hansj66/automaton-xl320/firmware/esp/balance-bot/README.md

## Suggested initial PID settings

P: 274
I: 1657
D: 3.3
Setpoint: 90.12
