hansj66/automaton-xl320/hardware/fusion/balance-bot/balancebot.jpg

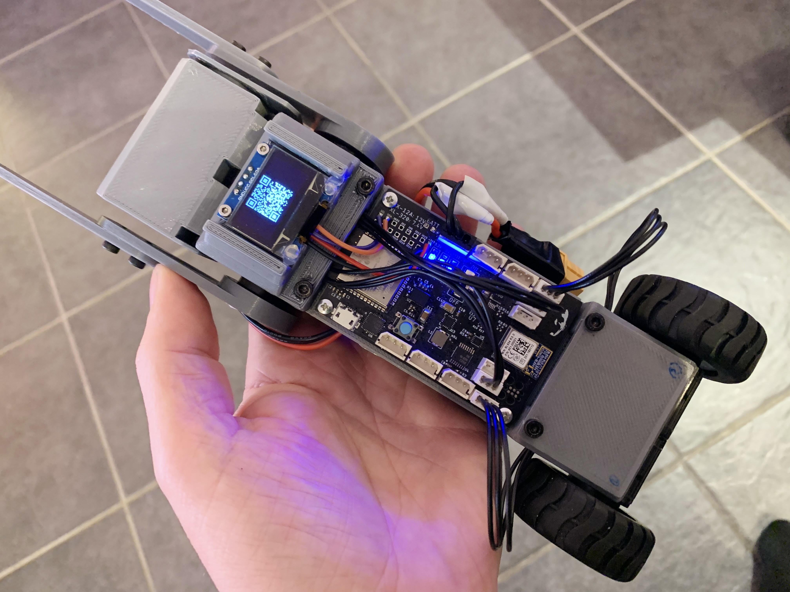
hardware/fusion/balance-bot/balancebot.jpg
