hansj66/automaton-xl320/hardware/fusion/hexapod/crab.png

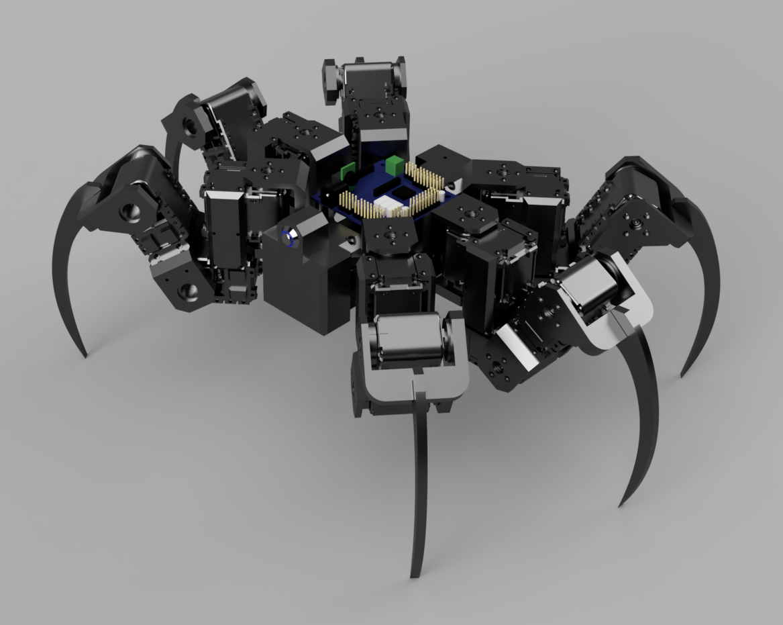
hardware/fusion/hexapod/crab.png
