hansj66/automaton-xl320/hardware/fusion/balance-bot/step/battery_cover.step

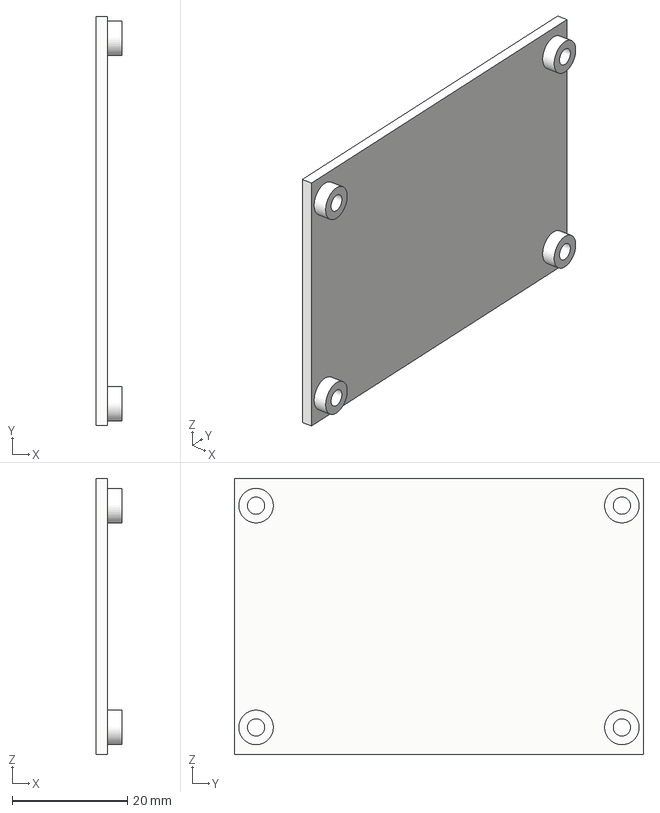
[picture p4: CAD file, 2021-12-13]
hardware/fusion/balance-bot/step/battery_cover.step
4.50 x 71.0 x 48.0 mm
