hansj66/automaton-xl320/hardware/fusion/hexapod/step/coxa.step

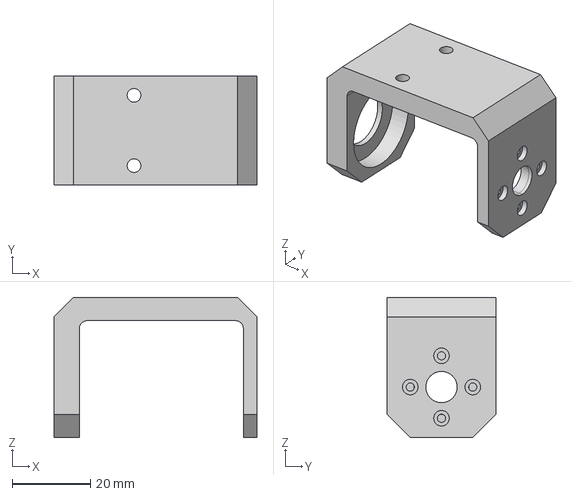
[picture p5: CAD file, 2021-09-20]
hardware/fusion/hexapod/step/coxa.step
52.0 x 27.8 x 36.0 mm
