hansj66/automaton-xl320/hardware/fusion/balance-bot/step/wide_wheel_hub_v2.step

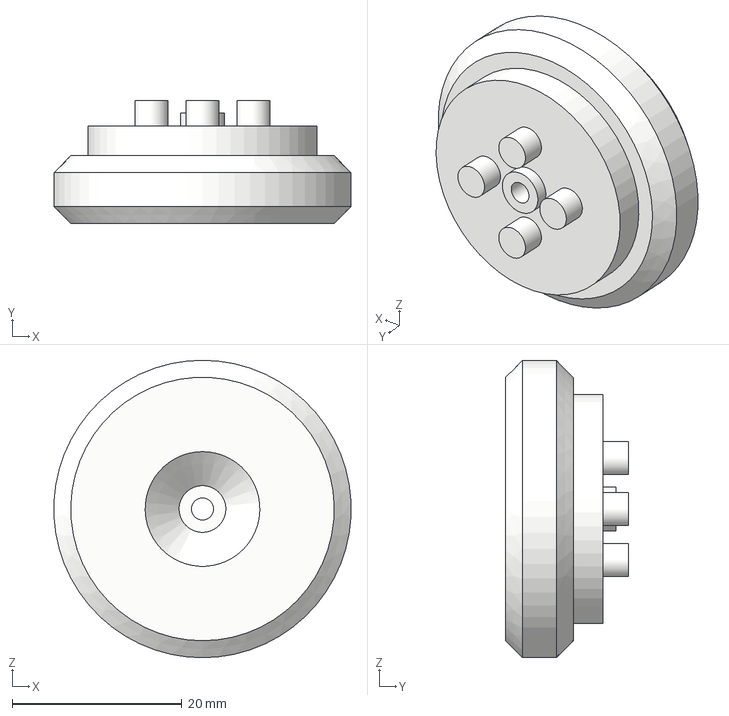
[picture p6: CAD file, 2021-12-13]
hardware/fusion/balance-bot/step/wide_wheel_hub_v2.step
34.9 x 14.5 x 35.0 mm
