hansj66/automaton-xl320/hardware/fusion/hexapod/step/end_effector.step

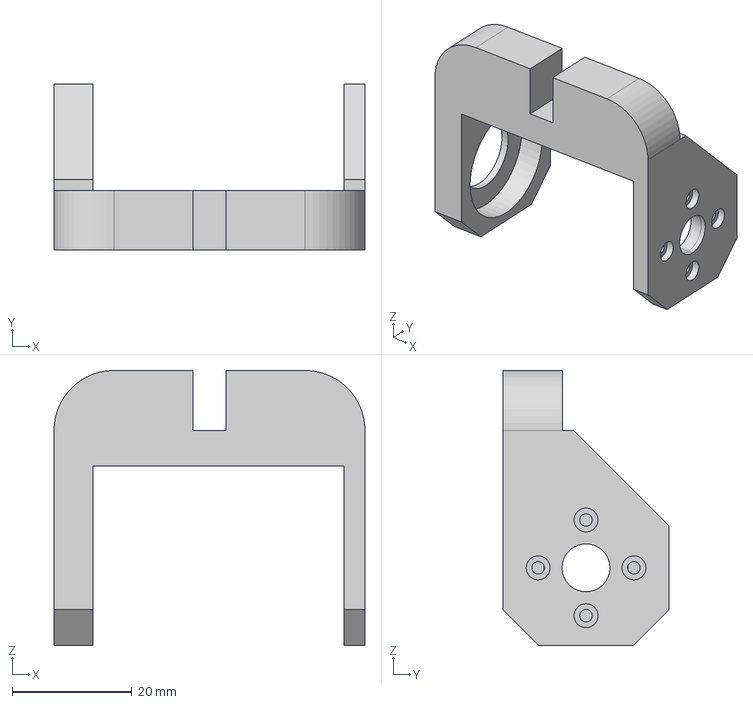
[picture p7: CAD file, 2021-09-20]
hardware/fusion/hexapod/step/end_effector.step
52.0 x 27.8 x 46.0 mm
