hansj66/automaton-xl320/hardware/fusion/balance-bot/step/servo_cover_2.step

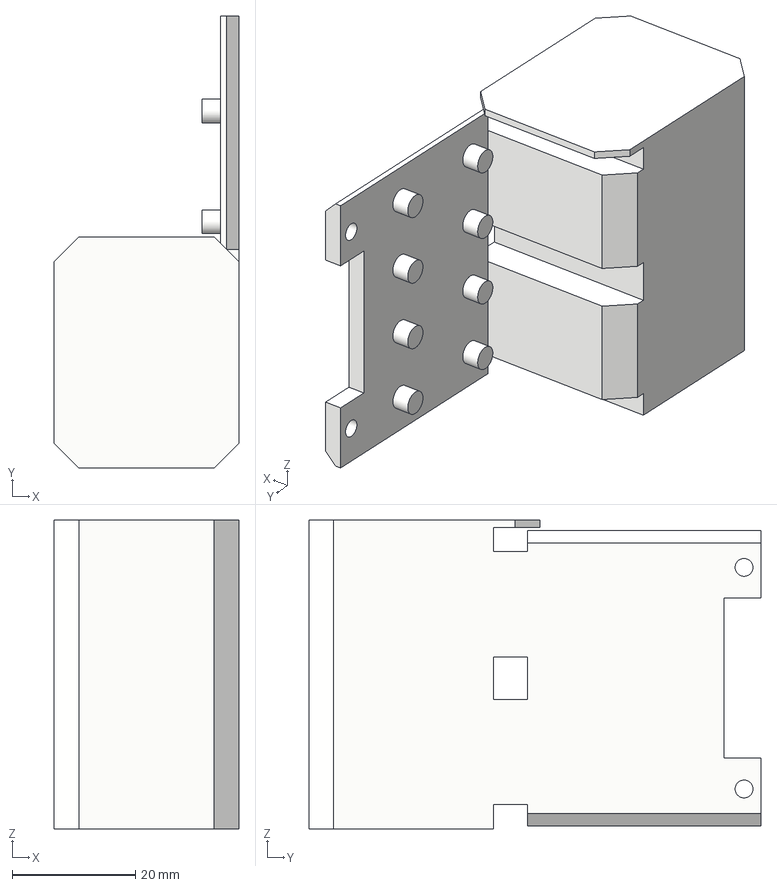
[picture p8: CAD file, 2021-12-13]
hardware/fusion/balance-bot/step/servo_cover_2.step
30.0 x 73.4 x 50.2 mm
