hansj66/automaton-xl320/hardware/fusion/hexapod/step/battery_clamp1.step

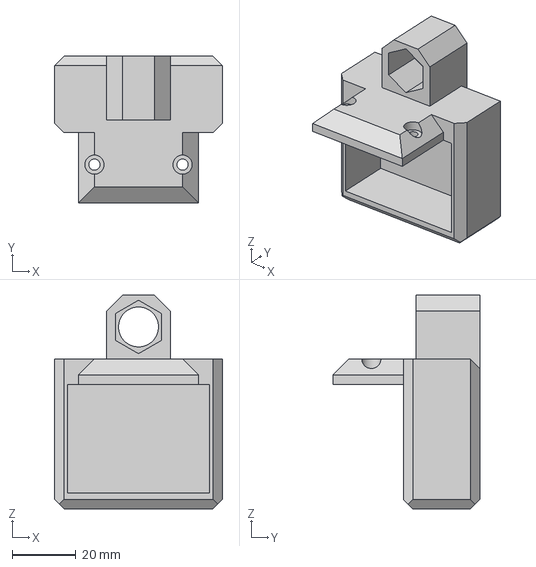
[picture p9: CAD file, 2021-09-20]
hardware/fusion/hexapod/step/battery_clamp1.step
52.6 x 46.0 x 67.0 mm
