hansj66/automaton-xl320/hardware/fusion/balance-bot/step/ballast_cover.step

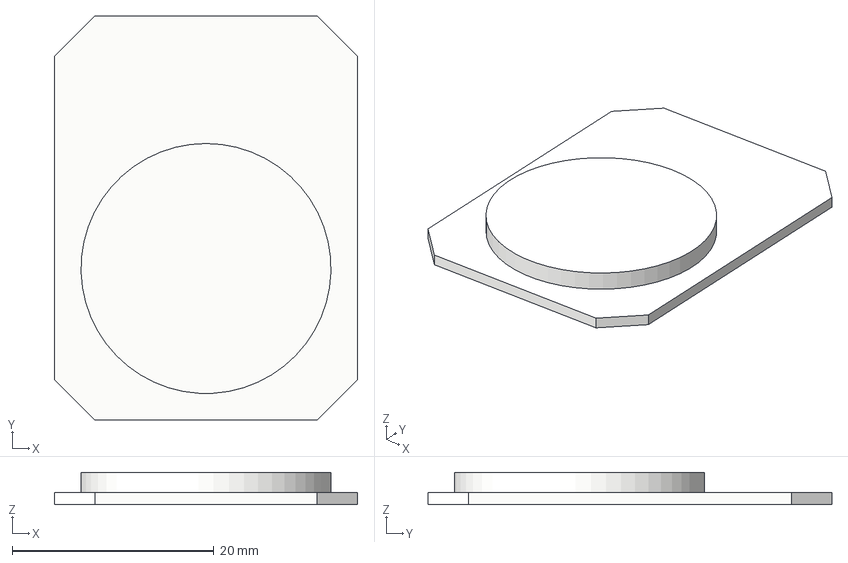
[picture p10: CAD file, 2021-12-13]
hardware/fusion/balance-bot/step/ballast_cover.step
30.0 x 40.0 x 3.20 mm
