hansj66/automaton-xl320/hardware/fusion/hexapod/step/tibia.step

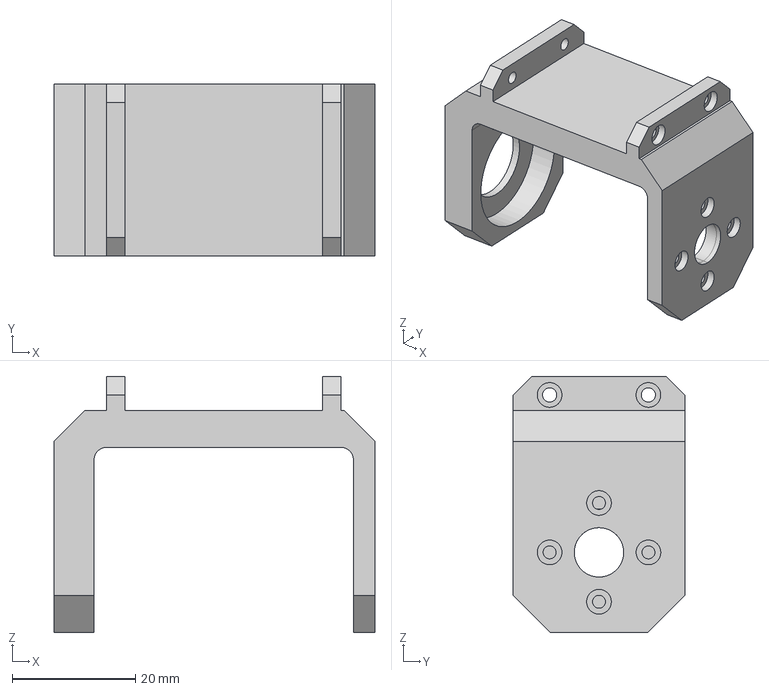
[picture p11: CAD file, 2021-09-20]
hardware/fusion/hexapod/step/tibia.step
52.0 x 27.8 x 41.5 mm
