hansj66/automaton-xl320/hardware/fusion/balance-bot/step/servo_cover_wheels.step

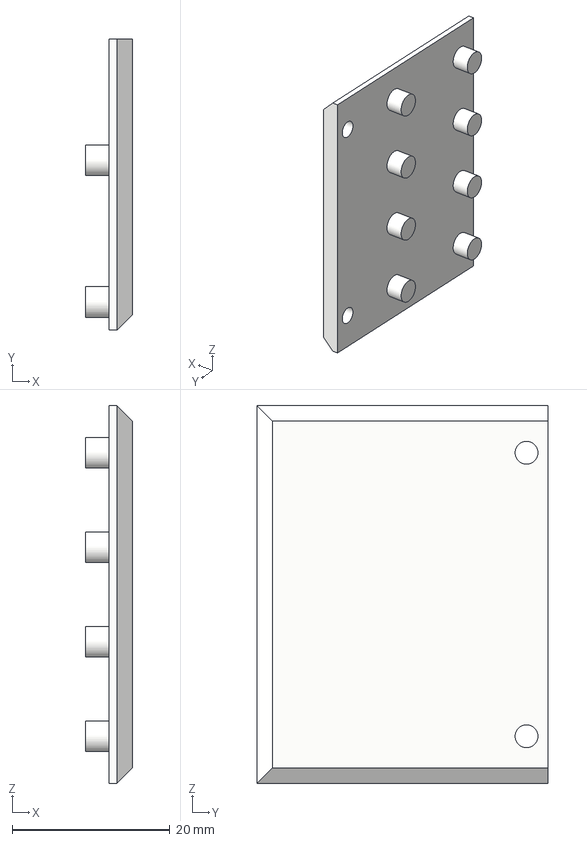
[picture p12: CAD file, 2021-12-13]
hardware/fusion/balance-bot/step/servo_cover_wheels.step
6.00 x 37.0 x 48.0 mm
