hansj66/automaton-xl320/hardware/fusion/hexapod/step/femur.step

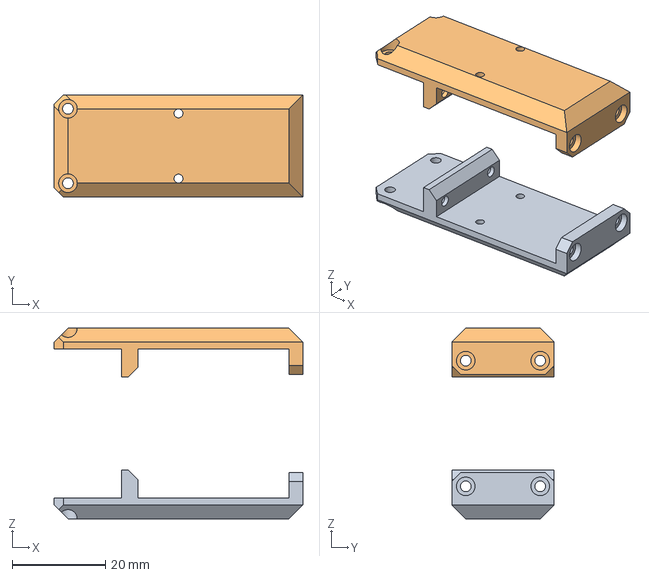
[picture p13: CAD file, 2021-09-20]
hardware/fusion/hexapod/step/femur.step
53.5 x 22.0 x 41.0 mm
