hansj66/automaton-xl320/hardware/fusion/balance-bot/step/arm.step

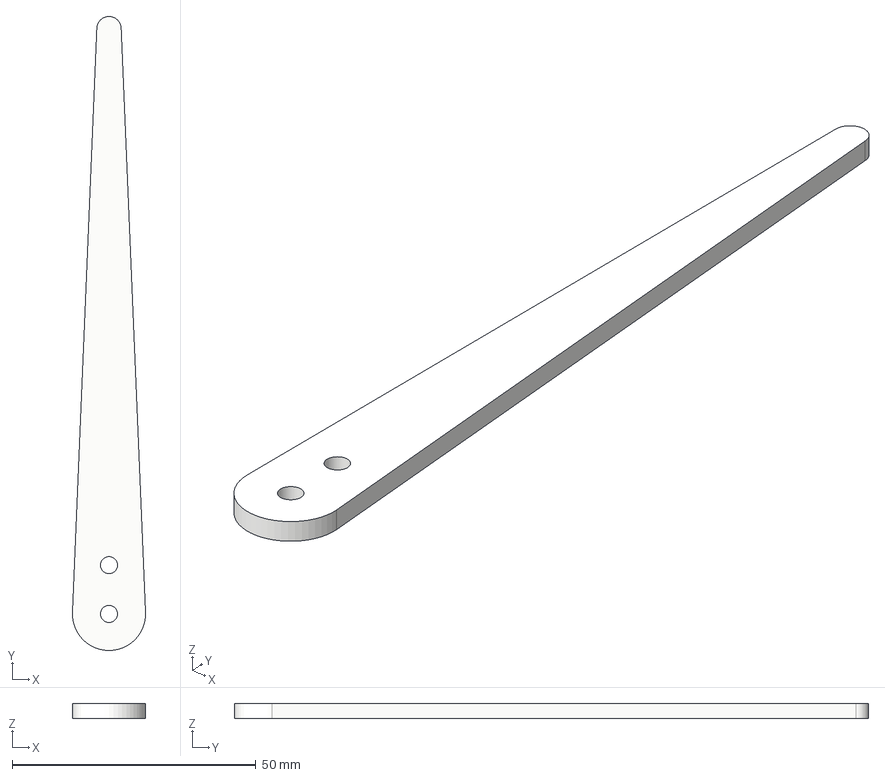
[picture p14: CAD file, 2021-12-13]
hardware/fusion/balance-bot/step/arm.step
15.0 x 130.0 x 3.00 mm
