hansj66/automaton-xl320/hardware/fusion/hexapod/step/Claw.step

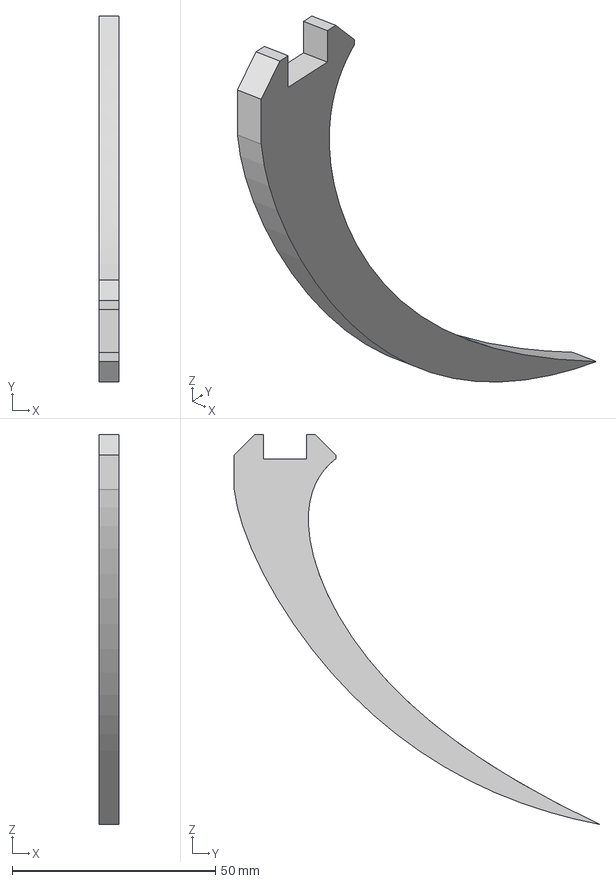
[picture p15: CAD file, 2021-09-20]
hardware/fusion/hexapod/step/Claw.step
5.00 x 90.0 x 96.0 mm
