hansj66/automaton-xl320/hardware/fusion/balance-bot/step/servo_cover_screen.step

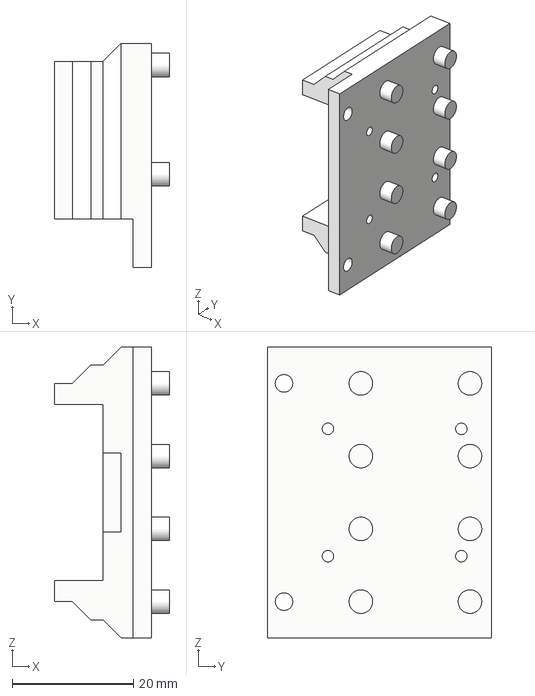
[picture p16: CAD file, 2021-12-13]
hardware/fusion/balance-bot/step/servo_cover_screen.step
19.0 x 37.0 x 48.0 mm
