hansj66/automaton-xl320/hardware/fusion/hexapod/step/pcb_standoff.step

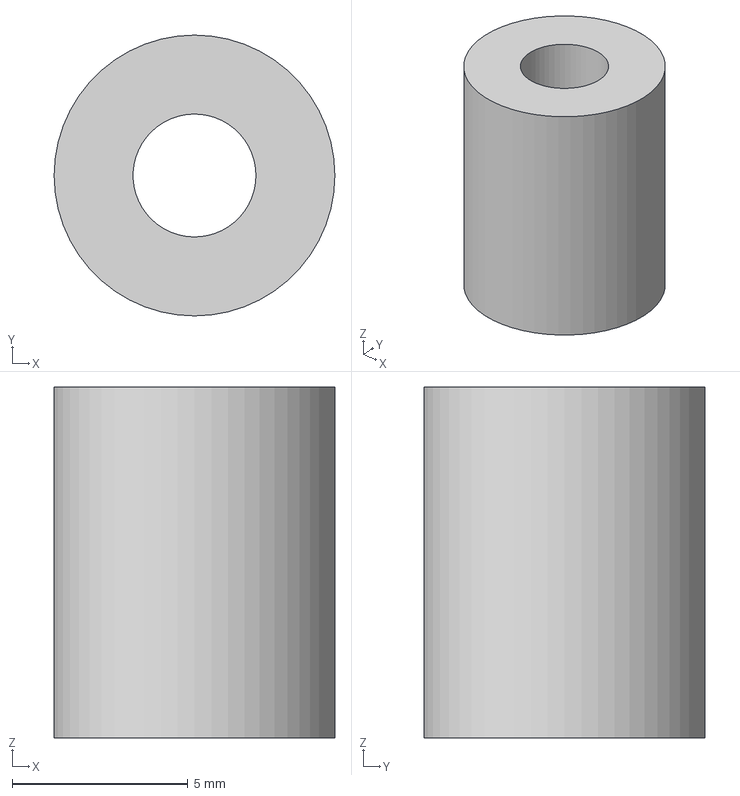
[picture p17: CAD file, 2021-09-20]
hardware/fusion/hexapod/step/pcb_standoff.step
8.00 x 8.00 x 10.00 mm
