hansj66/automaton-xl320/hardware/fusion/balance-bot/step/XL-320 v1.step

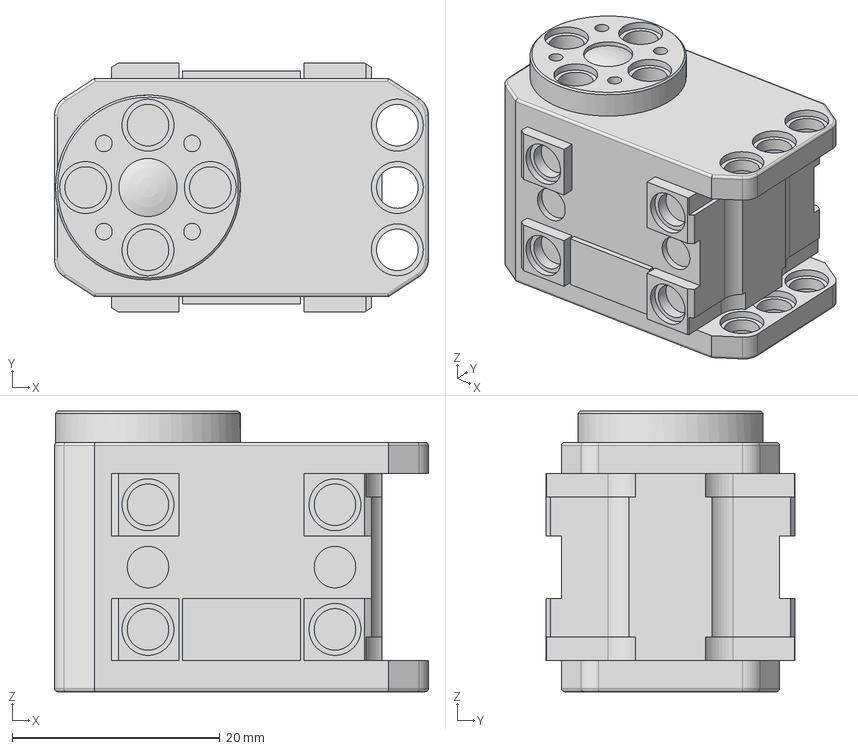
[picture p18: CAD file, 2021-12-13]
hardware/fusion/balance-bot/step/XL-320 v1.step
36.0 x 24.0 x 27.0 mm
