hansj66/automaton-xl320/hardware/fusion/hexapod/step/frame.step

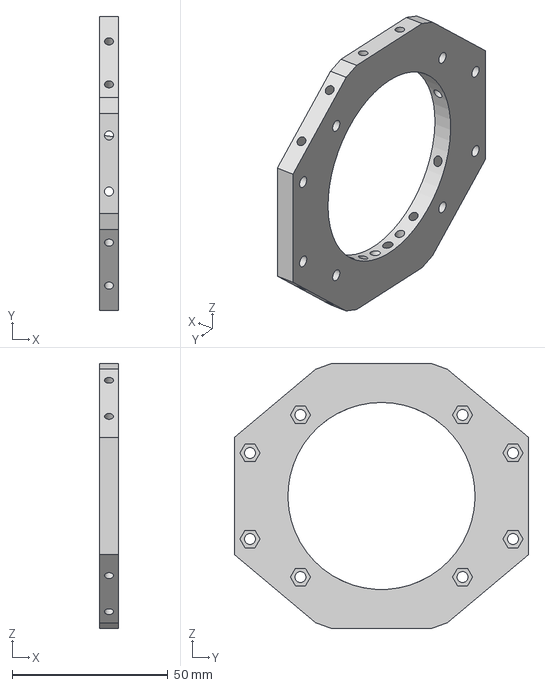
[picture p19: CAD file, 2021-09-20]
hardware/fusion/hexapod/step/frame.step
6.00 x 94.4 x 85.0 mm
