hansj66/automaton-xl320/hardware/fusion/balance-bot/step/shoulder_joint.step

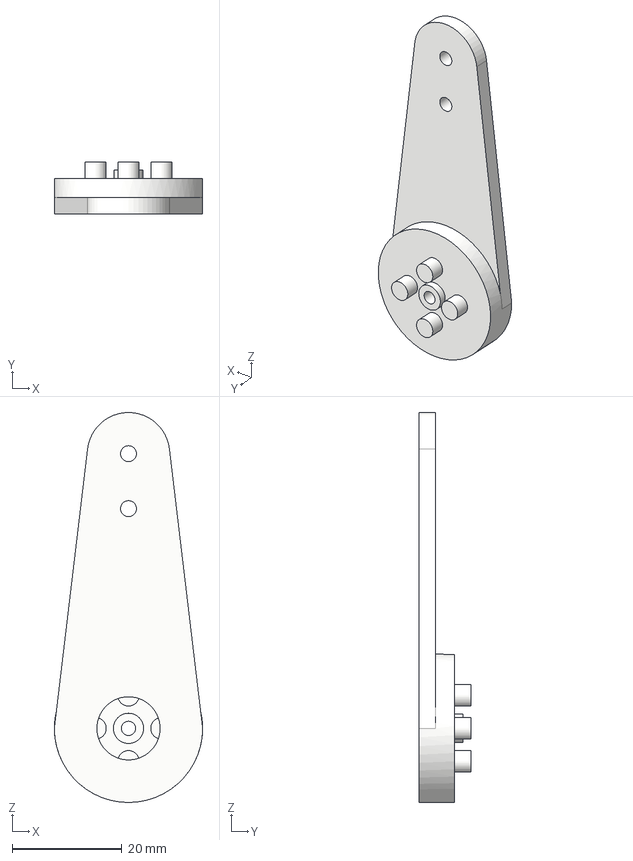
[picture p20: CAD file, 2021-12-13]
hardware/fusion/balance-bot/step/shoulder_joint.step
27.0 x 9.50 x 71.0 mm
