hansj66/automaton-xl320/hardware/fusion/hexapod/step/battery_clamp2.step

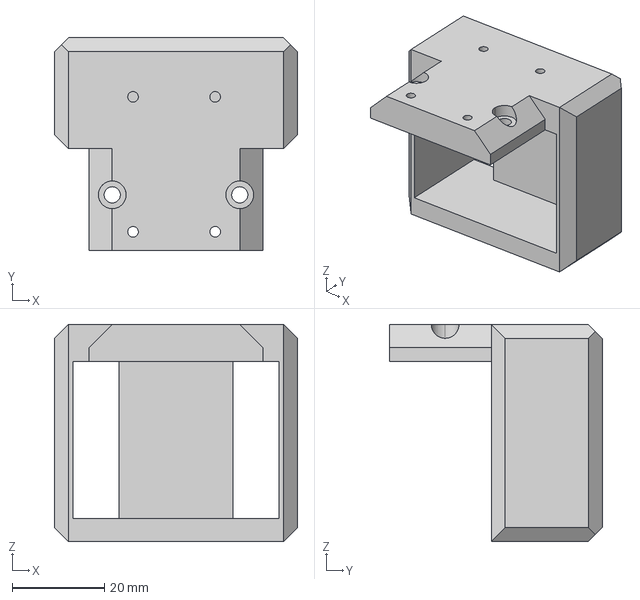
[picture p21: CAD file, 2021-09-20]
hardware/fusion/hexapod/step/battery_clamp2.step
52.6 x 46.0 x 47.0 mm
