hansj66/automaton-xl320/(list of files, cad)

Other CAD files:
hardware/fusion/balance-bot/step/bb_battery_cover.step
hardware/fusion/balance-bot/stl/arm.stl
hardware/fusion/balance-bot/stl/ballast_cover.stl
hardware/fusion/balance-bot/stl/battery_cover.stl
hardware/fusion/balance-bot/stl/servo_cover_screen.stl
hardware/fusion/balance-bot/stl/servo_cover_wheels.stl
hardware/fusion/balance-bot/stl/shoulder_joint.stl
hardware/fusion/balance-bot/stl/wide_wheel_hub_v2.stl
hardware/fusion/hexapod/stl/battery_clamp1.stl
hardware/fusion/hexapod/stl/battery_clamp2.stl
hardware/fusion/hexapod/stl/claw.stl
hardware/fusion/hexapod/stl/coxa.stl
hardware/fusion/hexapod/stl/end_effector.stl
hardware/fusion/hexapod/stl/femur.stl
hardware/fusion/hexapod/stl/frame.stl
hardware/fusion/hexapod/stl/pcb_standoff.stl
hardware/fusion/hexapod/stl/tibia.stl
