hansj66/automaton-xl320/hardware/eagle/AutomatonXL320/AutomatonXL320.brd

## EAGLE design hardware/eagle/AutomatonXL320/AutomatonXL320.brd (2024-04-30)

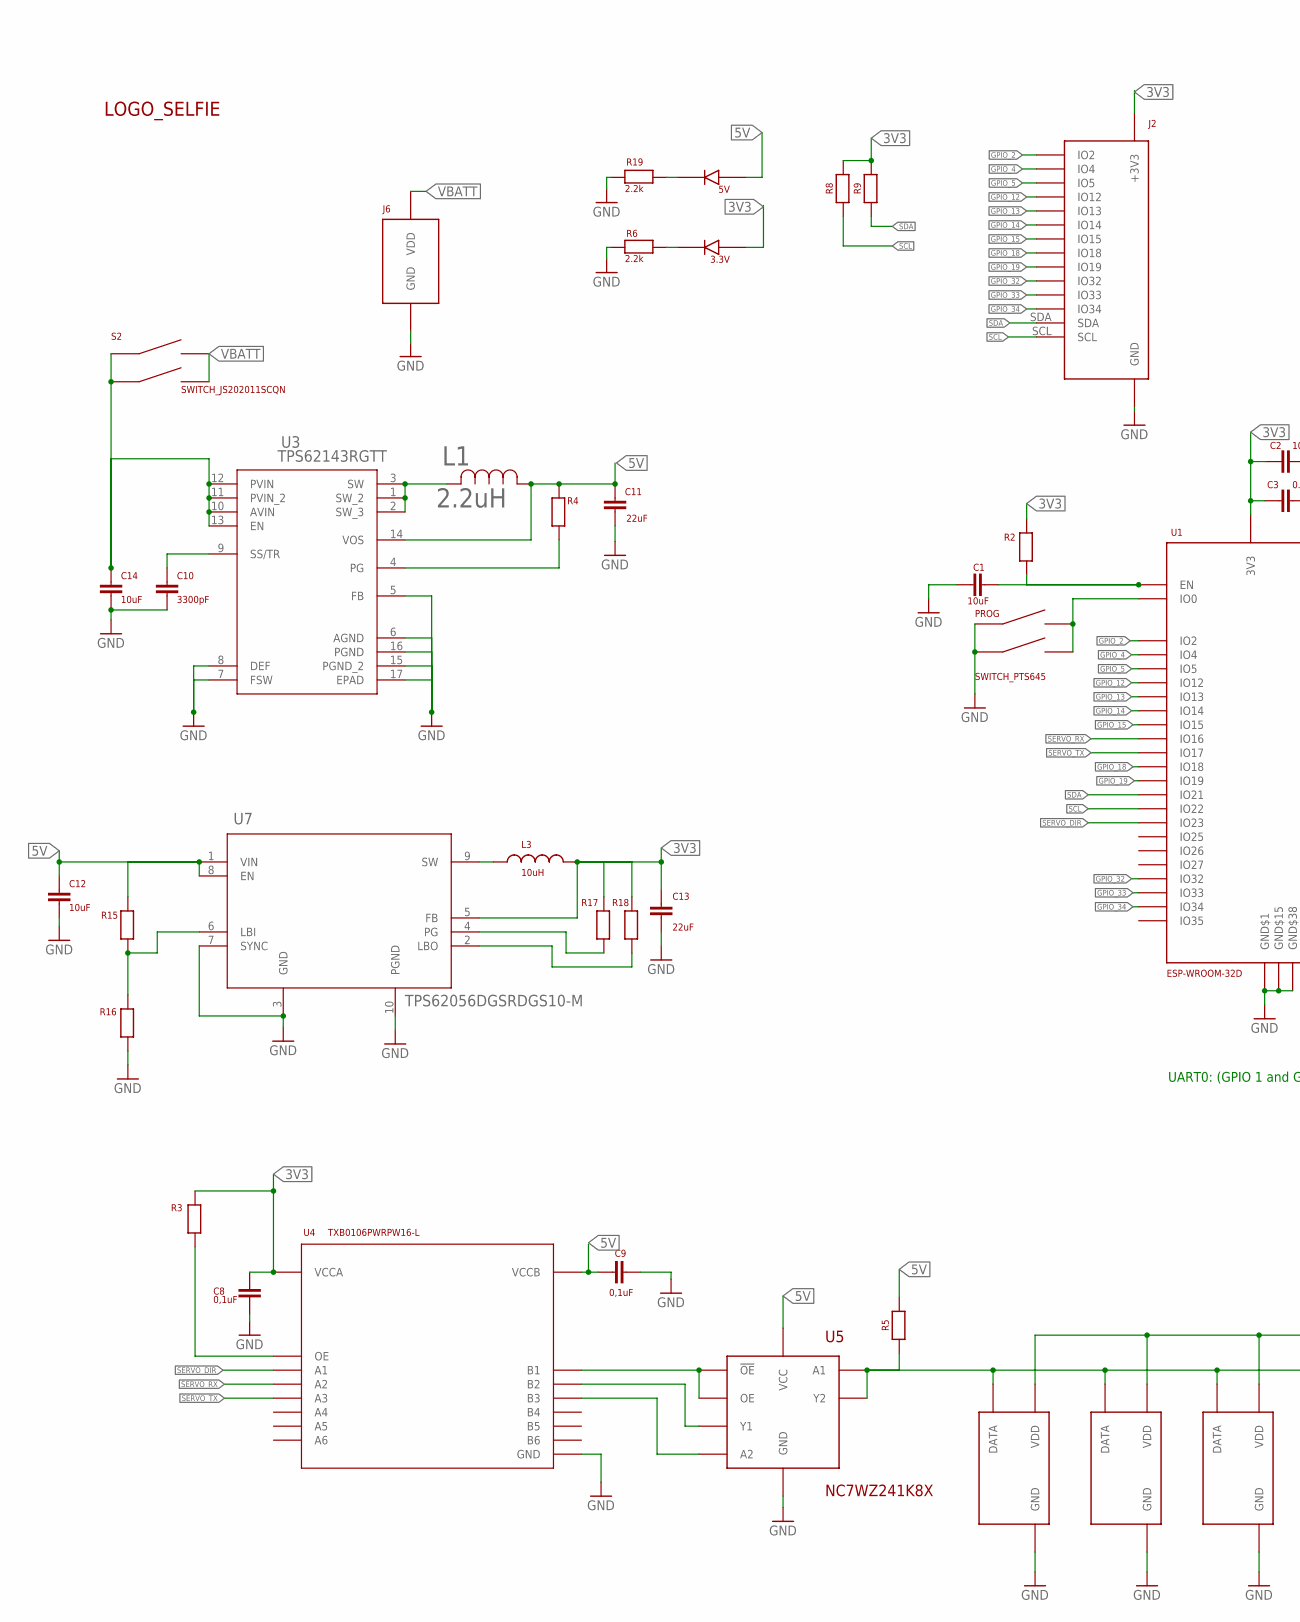
[picture p22: schematic AutomatonXL320.sch, part in row 1, column 1]

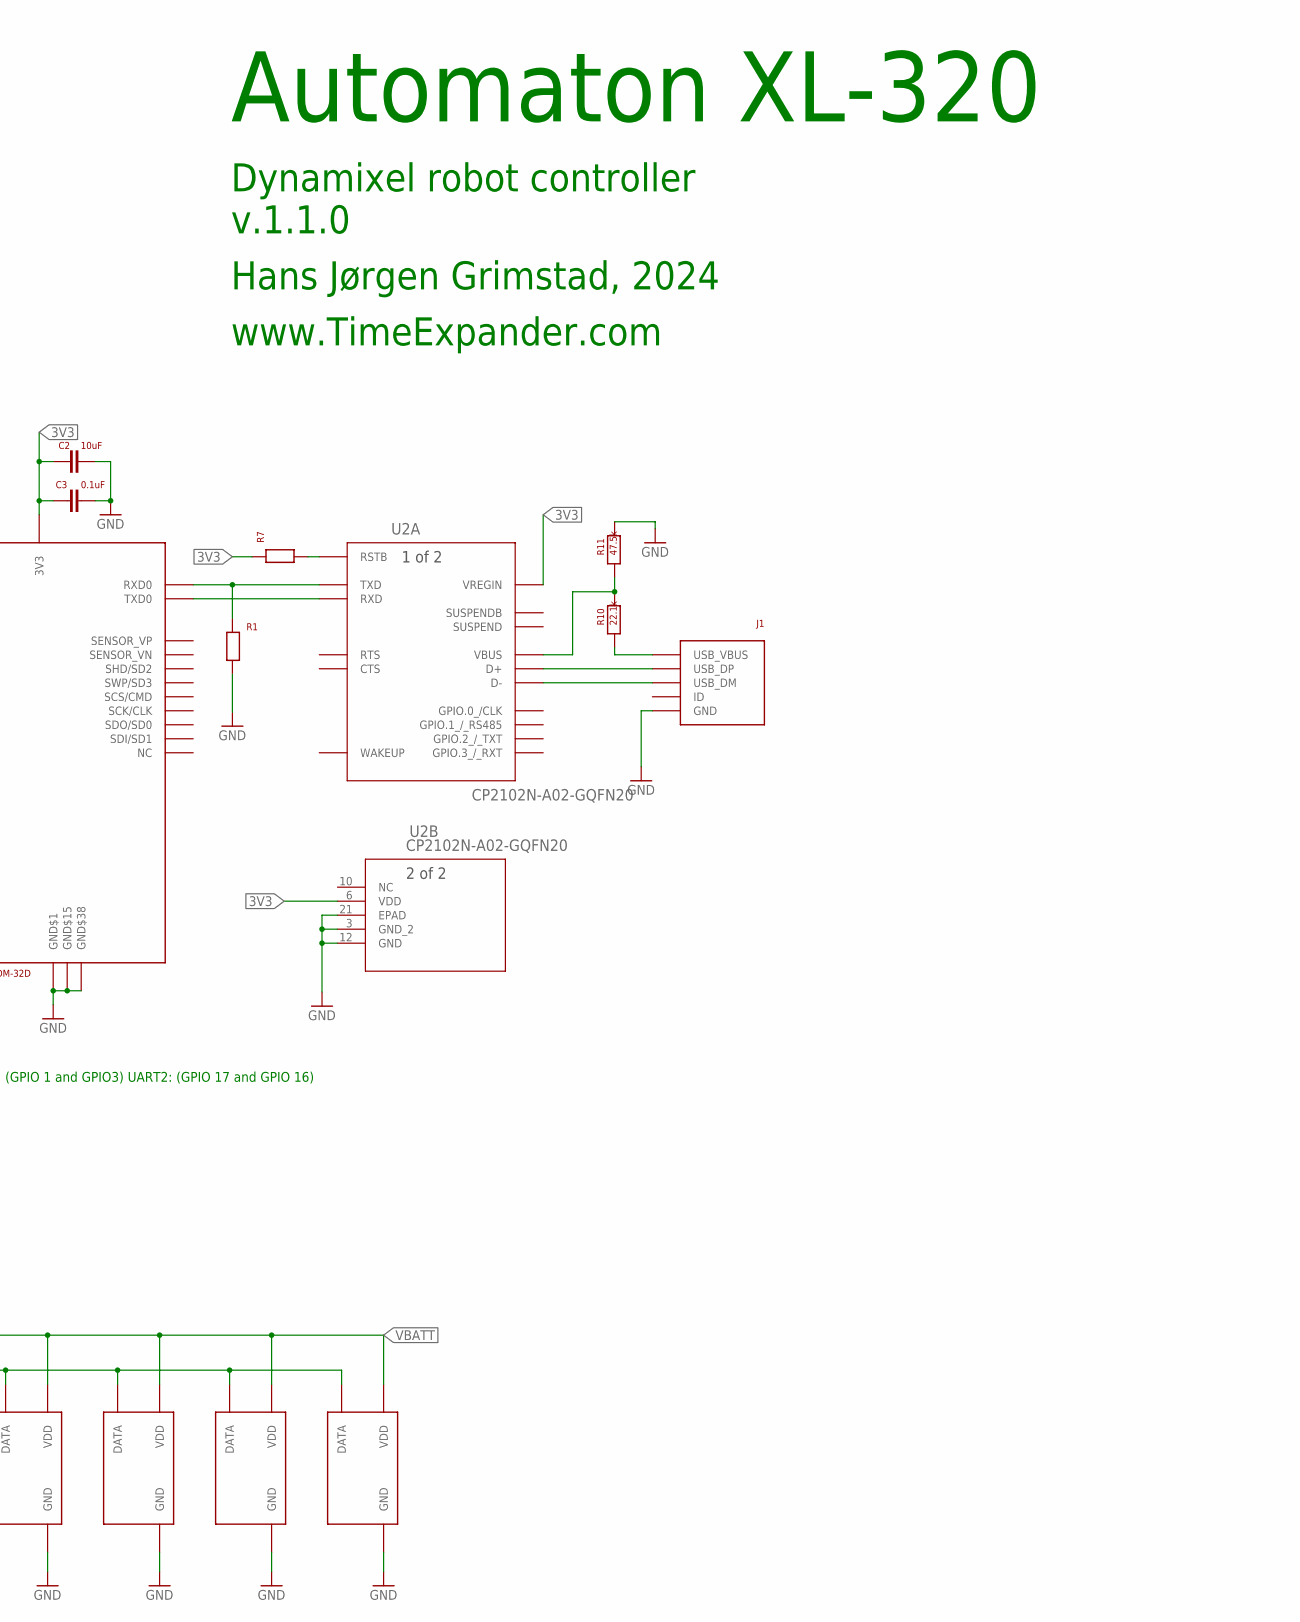
[picture p23: schematic AutomatonXL320.sch, part in row 1, column 2]

Parts:
3.3V, 5V: LED_APTR3216PBC/A
C1, C2: 10uF; CAP_0402
C3: 0.1uF; CAP_0402
C8, C9: 0,1uF; CAP_0402
C10: 3300pF; CAP_0402
C11, C13: 22uF; CAP_1206
C12, C14: 10uF; CAP_1206
J1: USB_RCPT_10118192-0001LF
J2: ESP_ROBOT_BOARD_GPIO_16
J6: BATTERY; BATTERY_SOLDER_TERMINAL
L1: 2.2uH; IND_IHLP-1616AB-M
L3: 10uH; IND_4028
PROG: SWITCH_PTS645; SWITCH_PTS645_EE_NBIOT_01
R1, R2, R3, R4, R5, R7, R8, R9, R15, R16, R17, R18: RESISTOR0402; RES_0402
R6, R19: 2.2k; RES_0402
R10: 22.1k; RES_0402
R11: 47.5k; RES_0402
S2: SWITCH_JS202011SCQN
U1: ESP-WROOM-32D; ESP_WROOM_32D
U2: CP2102N-A02-GQFN20; QFN20_CP2102N_SIL
U3: TPS62143RGTT; RGT16_1P7X1P7
U4: TXB0106PWRPW16-L; PW16-L
U5: NC7WZ241K8X
U7: TPS62056DGSRDGS10-M; DGS10-M
U$1, U$4, U$5, U$6, U$8, U$9: DYNAMIXEL_MOLEX_MINISPOX_3P_HEADERXL-320; DYNAMIXEL_MICROLATCH_3P_HEADER
U$2: LOGO_SELFIESELFIE_2; TIMEEXPANDER_LOGO_1

Connections:
3V3: 3.3V.A, C2.P$1 (1), C3.P$1 (1), C8.P$2 (2), C13.P$1 (1), J2.+3V3, L3.2, R2.P$2, R3.P$2, R7.P$1, R8.P$2, R9.P$2, R17.P$2, R18.P$2, U1.2 (3V3), U2.6 (VDD), U2.7 (VREGIN), U4.2 (VCCA), U7.5 (FB)
5V: 5V.A, C9.P$1 (1), C11.P$1 (1), C12.P$1 (1), L1.1, R4.P$2, R5.P$2, R15.P$2, U3.14 (VOS), U4.15 (VCCB), U5.VCC, U7.1 (VIN), U7.8 (EN)
GND: C1.P$1 (1), C2.P$2 (2), C3.P$2 (2), C8.P$1 (1), C9.P$2 (2), C10.P$2 (2), C11.P$2 (2), C12.P$2 (2), C13.P$2 (2), C14.P$2 (2), J1.GND, J2.GND, J6.- (GND), PROG.A1, PROG.A2, R1.P$2, R6.P$1, R11.P$2, R16.P$1, R19.P$1, U1.1 (GND$1), U1.15 (GND$15), U1.38 (GND$38), U1.GND$39 (GND$38), U1.GND$40 (GND$38), U1.GND$41 (GND$38), U1.GND$42 (GND$38), U1.GND$43 (GND$38), U1.GND$44 (GND$38), U1.GND$45 (GND$38), U1.GND$46 (GND$38), U1.GND$47 (GND$38), U2.3 (GND_2), U2.12 (GND), U2.21 (EPAD), U3.5 (FB), U3.6 (AGND), U3.7 (FSW), U3.8 (DEF), U3.15 (PGND_2), U3.16 (PGND), U3.17 (EPAD), U4.9 (GND), U5.GND, U7.3 (GND), U7.7 (SYNC), U7.10 (PGND), U$1.GND, U$4.GND, U$5.GND, U$6.GND, U$8.GND, U$9.GND
GPIO_2: J2.IO2, U1.24 (IO2)
GPIO_4: J2.IO4, U1.26 (IO4)
GPIO_5: J2.IO5, U1.29 (IO5)
GPIO_12: J2.IO12, U1.14 (IO12)
GPIO_13: J2.IO13, U1.16 (IO13)
GPIO_14: J2.IO14, U1.13 (IO14)
GPIO_15: J2.IO15, U1.23 (IO15)
GPIO_18: J2.IO18, U1.30 (IO18)
GPIO_19: J2.IO19, U1.31 (IO19)
GPIO_32: J2.IO32, U1.8 (IO32)
GPIO_33: J2.IO33, U1.9 (IO33)
GPIO_34: J2.IO34, U1.6 (IO34)
unnamed: C1.P$2 (2), R2.P$1, U1.3 (EN)
unnamed: 3.3V.C, R6.P$2
unnamed: C10.P$1 (1), U3.9 (SS/TR)
unnamed: R1.P$1, U1.34 (RXD0), U2.18 (TXD)
unnamed: U1.35 (TXD0), U2.17 (RXD)
unnamed: PROG.B1, PROG.B2, U1.25 (IO0)
unnamed: L1.2, U3.1 (SW_2), U3.2 (SW_3), U3.3 (SW)
unnamed: U4.16 (B1), U5.!OE, U5.OE
unnamed: R4.P$1, U3.4 (PG)
unnamed: U4.14 (B2), U5.Y1
unnamed: U4.13 (B3), U5.A2
unnamed: R7.P$2, U2.9 (RSTB)
unnamed: C14.P$1 (1), S2.2 (A2), S2.5 (A1), U3.10 (AVIN), U3.11 (PVIN_2), U3.12 (PVIN), U3.13 (EN)
unnamed: R3.P$1, U4.8 (OE)
unnamed: J1.VCC (USB_VBUS), R10.P$1
unnamed: J1.D+ (USB_DP), U2.4 (D+)
unnamed: J1.D- (USB_DM), U2.5 (D-)
unnamed: R10.P$2, R11.P$1, U2.8 (VBUS)
unnamed: R5.P$1, U5.A1, U5.Y2, U$1.DATA, U$4.DATA, U$5.DATA, U$6.DATA, U$8.DATA, U$9.DATA
unnamed: 5V.C, R19.P$2
unnamed: R15.P$1, R16.P$2, U7.6 (LBI)
unnamed: L3.1, U7.9 (SW)
unnamed: R17.P$1, U7.4 (PG)
unnamed: R18.P$1, U7.2 (LBO)
SCL: J2.SCL, R8.P$1, U1.36 (IO22)
SDA: J2.SDA, R9.P$1, U1.33 (IO21)
SERVO_DIR: U1.37 (IO23), U4.1 (A1)
SERVO_RX: U1.27 (IO16), U4.3 (A2)
SERVO_TX: U1.28 (IO17), U4.4 (A3)
VBATT: J6.+ (VDD), S2.3 (B2), S2.6 (B1), U$1.VDD, U$4.VDD, U$5.VDD, U$6.VDD, U$8.VDD, U$9.VDD

Notes on the sheet:
Automaton XL-320
Dynamixel robot controller
v.1.1.0
Hans Jørgen Grimstad, 2024
www.TimeExpander.com
UART0: (GPIO 1 and GPIO3) UART2: (GPIO 17 and GPIO 16)

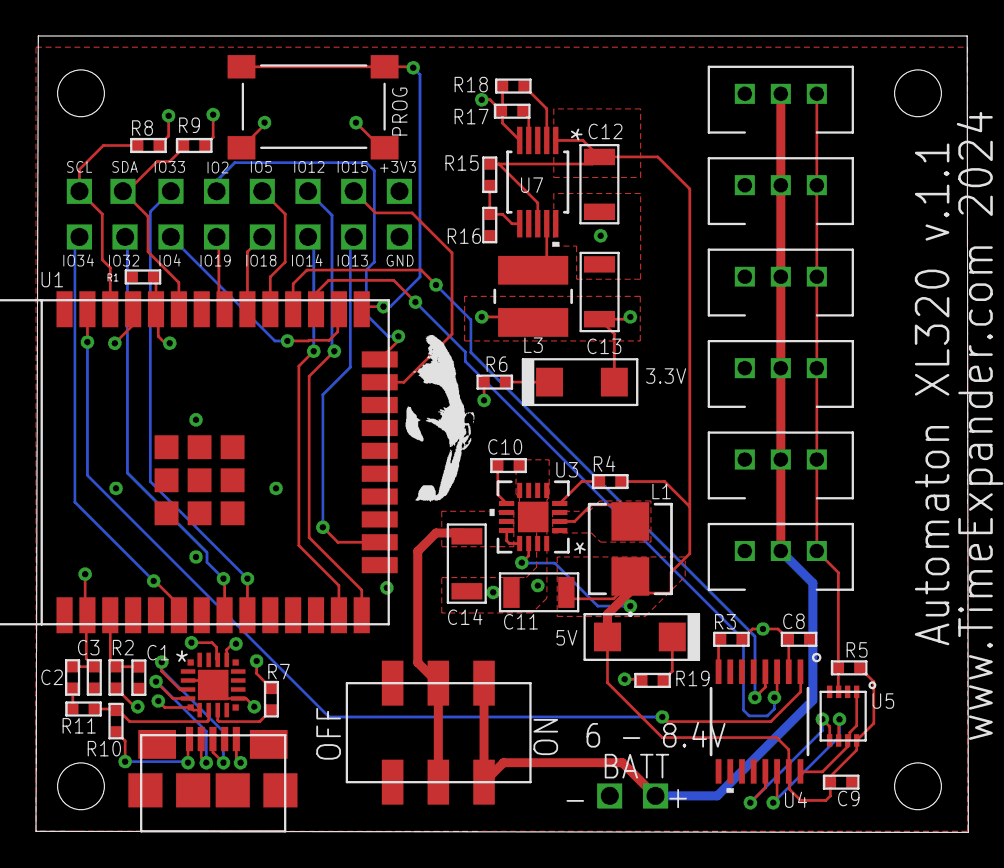
[picture p24: board AutomatonXL320.brd from above]

Board: 4 copper layers, 51.8 x 44.2 mm, 48 parts (0 on the bottom side), 45 nets.
