hansj66/automaton-xl320/firmware/esp/balance-bot/src/display.h

#ifndef _DISPLAY_H_
#define _DISPLAY_H_

class Display
{
    public:
        Display();
        void Begin();
        void DisplayText(const char * text, int waitms = 0);
        void DisplayQRCode(char * buf);
};



#endif // _DISPLAY_H_
