hansj66/automaton-xl320/(commit log)

2021-11-14 Added display, nvs, calibration
2021-11-28 Added web PID control
    * Changed PID algorithm
    * Displaying QR code with URL
2021-12-04 Added NVS save + load of PID params
    * Updated config page with boogie + greet buttons
    * Not forcing recalibration at normal rest position
    * Commented out kalman stuff
    * Added sensible default PID values
    * Added greet + boogie handlers to mux
    * Slowed down Rise() function
2021-12-13 Updated README with suggested initial PID parameters
2021-12-13 Updated STL and STEP files
    * Balance bot
    [XL-320 v1.step, arm.step, arm.stl, ballast_cover.step, ballast_cover.stl, battery_cover.step, battery_cover.stl, bb_battery_cover.stl]
2021-12-13 Removed dead autotuning code
    * Would have taken too long to converge anyway
    [poser.cpp, poser.h]
2024-02-20 Added new (smaller) board
    * Only XL-320
    [Automaton320.brd, Automaton320.sch, AutomatonXL320.brd, AutomatonXL320.sch]
2024-04-30 CP2102N VBUS is now connected via resistor ladder
    * CP2102N was overheating at times because it was
    connected directly to USB VBUS
    [AutomatonXL320.brd, AutomatonXL320.sch]
