hansj66/automaton-xl320/(notices)

Notices in the files:
parts and their libraries:
COPYRIGHT: Copyright (C) 2018 Accelerated Designs. All rights reserved
TimeExpander2: COPYRIGHT: Copyright (C) 2023 Ultra Librarian. All rights reserved.
